kushima8/tks4/README.md

# tks4
teikei san 4Key Macro Pad  



[ビルドガイド（日本語）](Documents/buildguide.md)
