kushima8/tks4/pcb/tks4.pdf

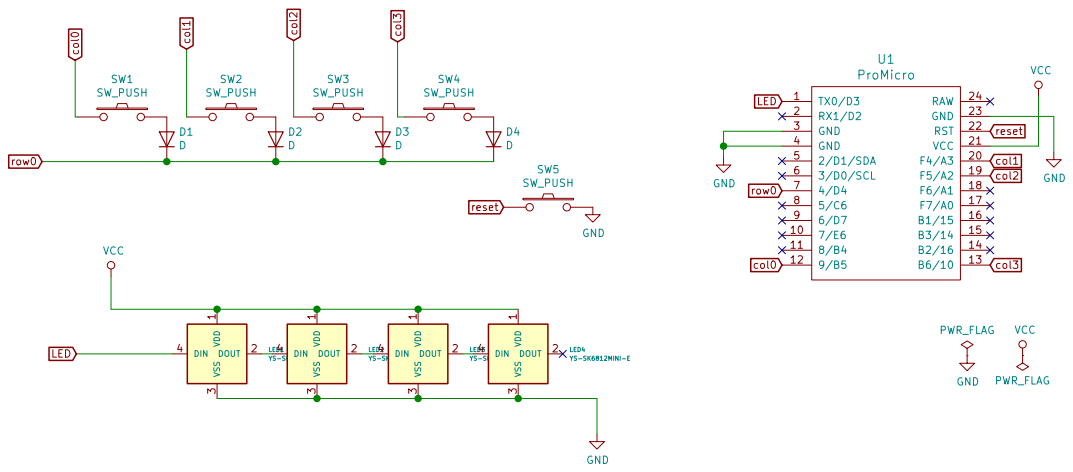
[picture p1: page 1]

1 DOUT 2 VSS 3 DIN 4 LED1 YS-SK6812MINI-E VCC

1 DOUT 2 VSS 3 DIN 4 LED2 YS-SK6812MINI-EVDD
PWR_FLAG VDD

1 DOUT 2 VSS 3 DIN 4 LED3 YS-SK6812MINI-EVDD

1 DOUT 2 VSS 3 DIN 4 LED4 YS-SK6812MINI-E GND

Id: 1/1 Title: File: tks4.sch Sheet: /
