kushima8/tks4/pcb/tks4.sch

## KiCad design pcb/tks4.sch (2023-05-04)

Schematic: tks4.sch

Parts:
D1, D2, D3, D4: D; D3_TH_SMD
LED1, LED2, LED3, LED4: YS-SK6812MINI-E
SW1, SW2, SW3, SW4: SW_PUSH; CherryMX_1u
SW5: SW_PUSH; ResetSW
U1: ProMicro; ProMicro_v3.5
